phckopper/capivara-hardware/2019-05-20 17.54.45.jpg

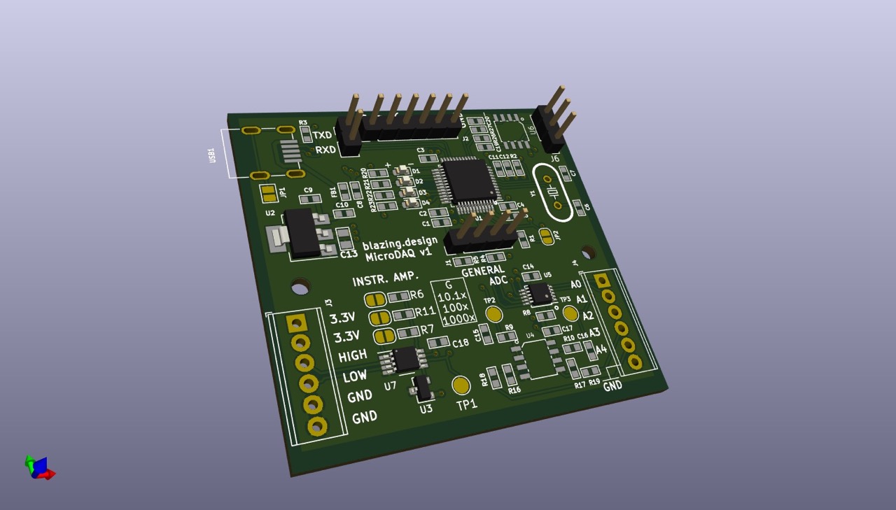
2019-05-20 17.54.45.jpg
