phckopper/capivara-hardware/Schematic.pdf/Capivara.pdf

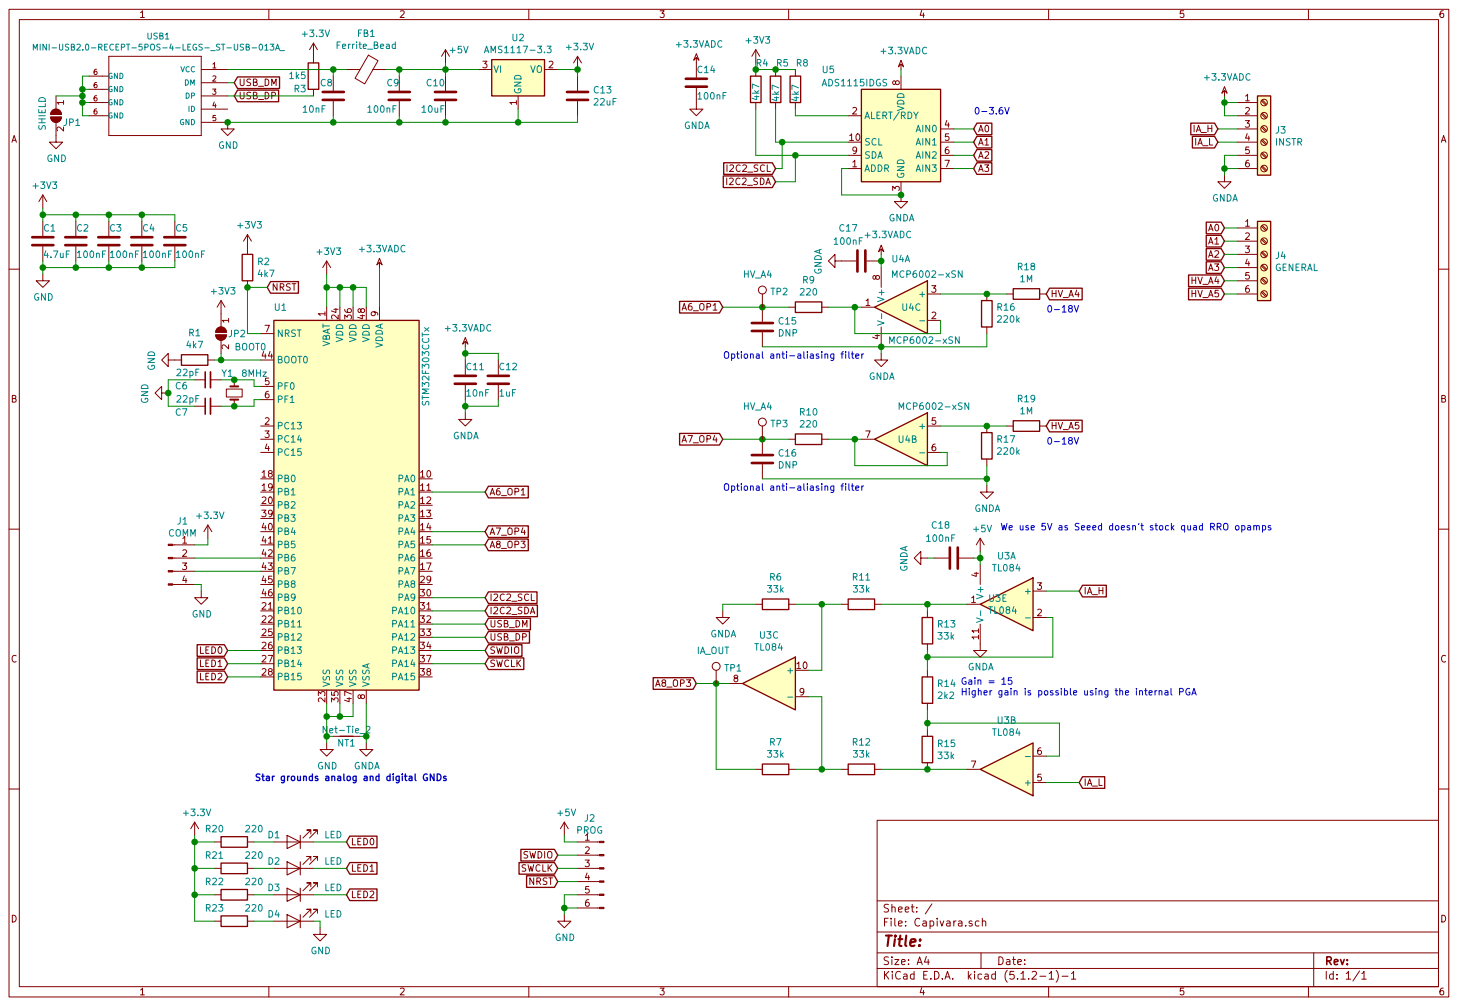
[picture p2: page 1]

1 VDD 24 VDD 36 VDD 48 VDDA

9 VSS 23 VSS 35 VSS 47 VSSA

We use 5V as Seeed doesn't stock quad RRO opamps R11

File: Capivara.sch Sheet: /
Id: 1/1 Title:
