phckopper/capivara-hardware/Assembly/PCB_Assembly.pdf

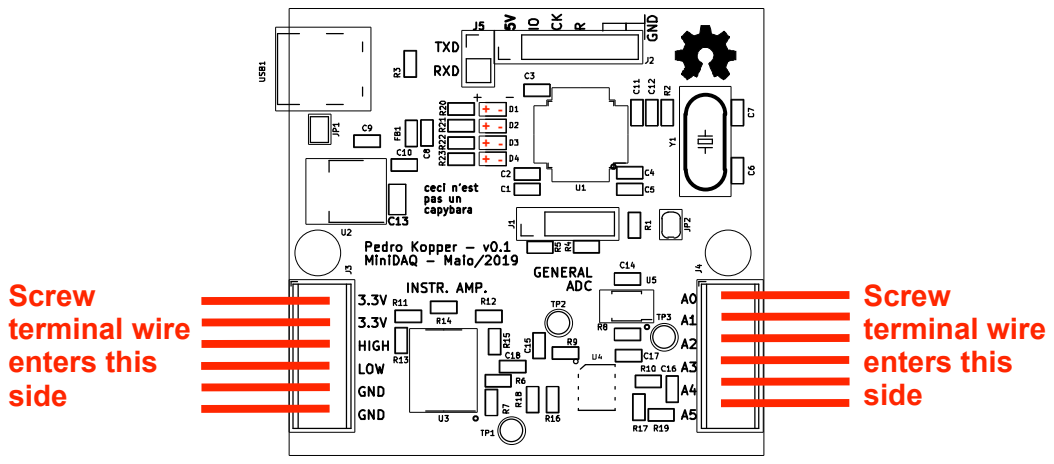
[picture p3: page 1]
