phckopper/capivara-hardware/Fabrication/PCB_Assembly.pdf

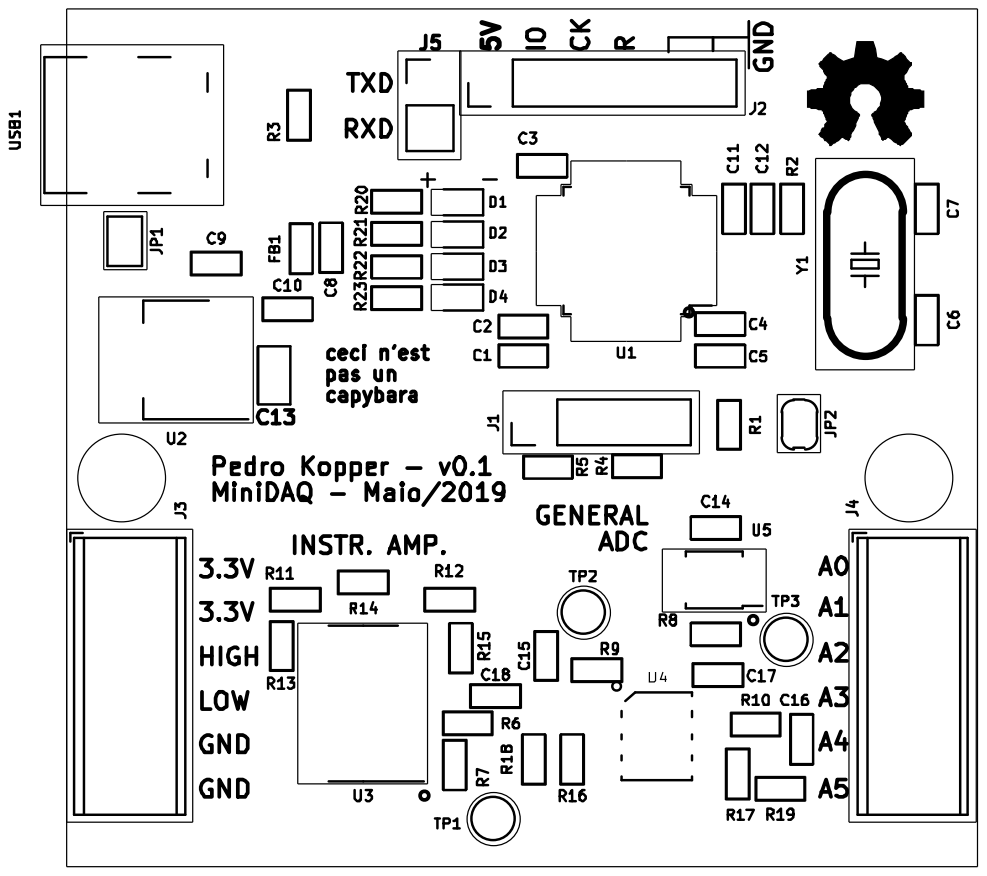
[picture p4: page 1]
