phckopper/capivara-hardware/EsquemaV0.4.pdf

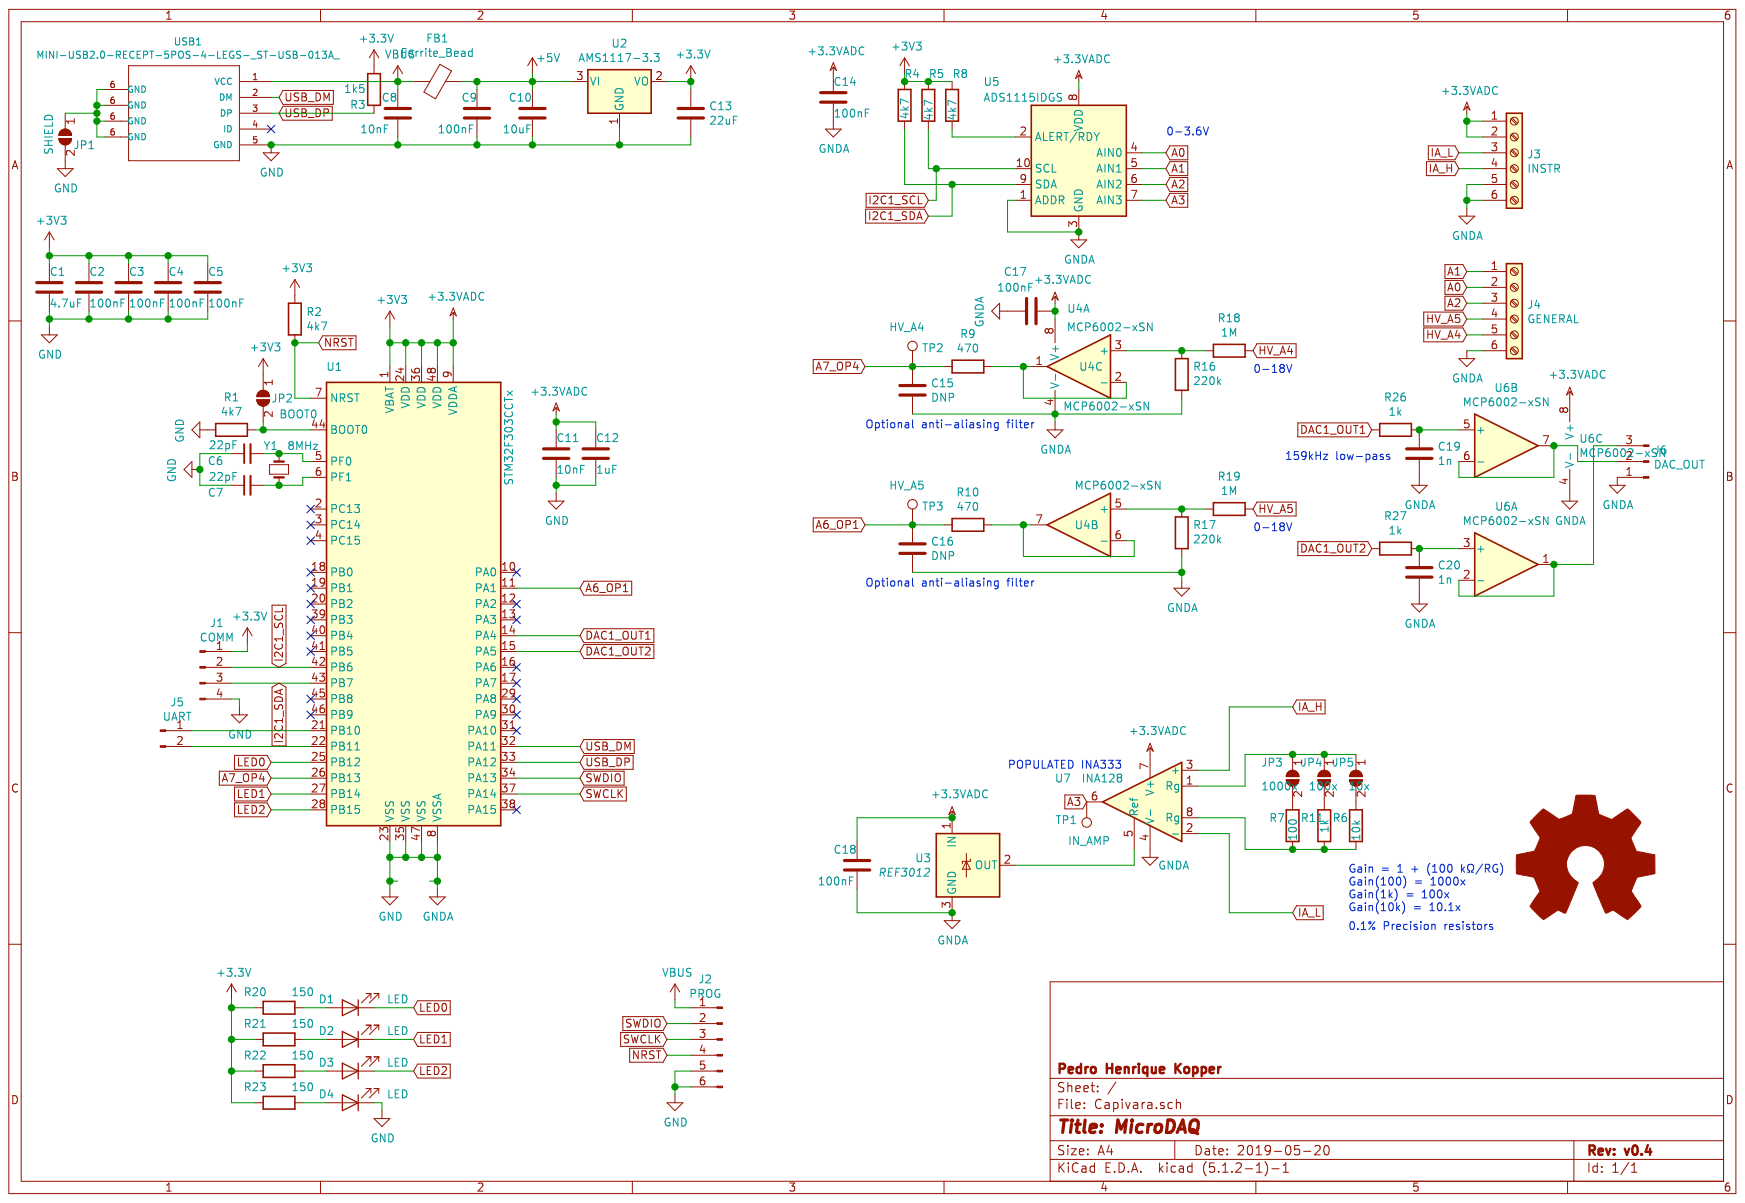
[picture p5: page 1]
