phckopper/capivara-hardware/Esquema_Final2.pdf

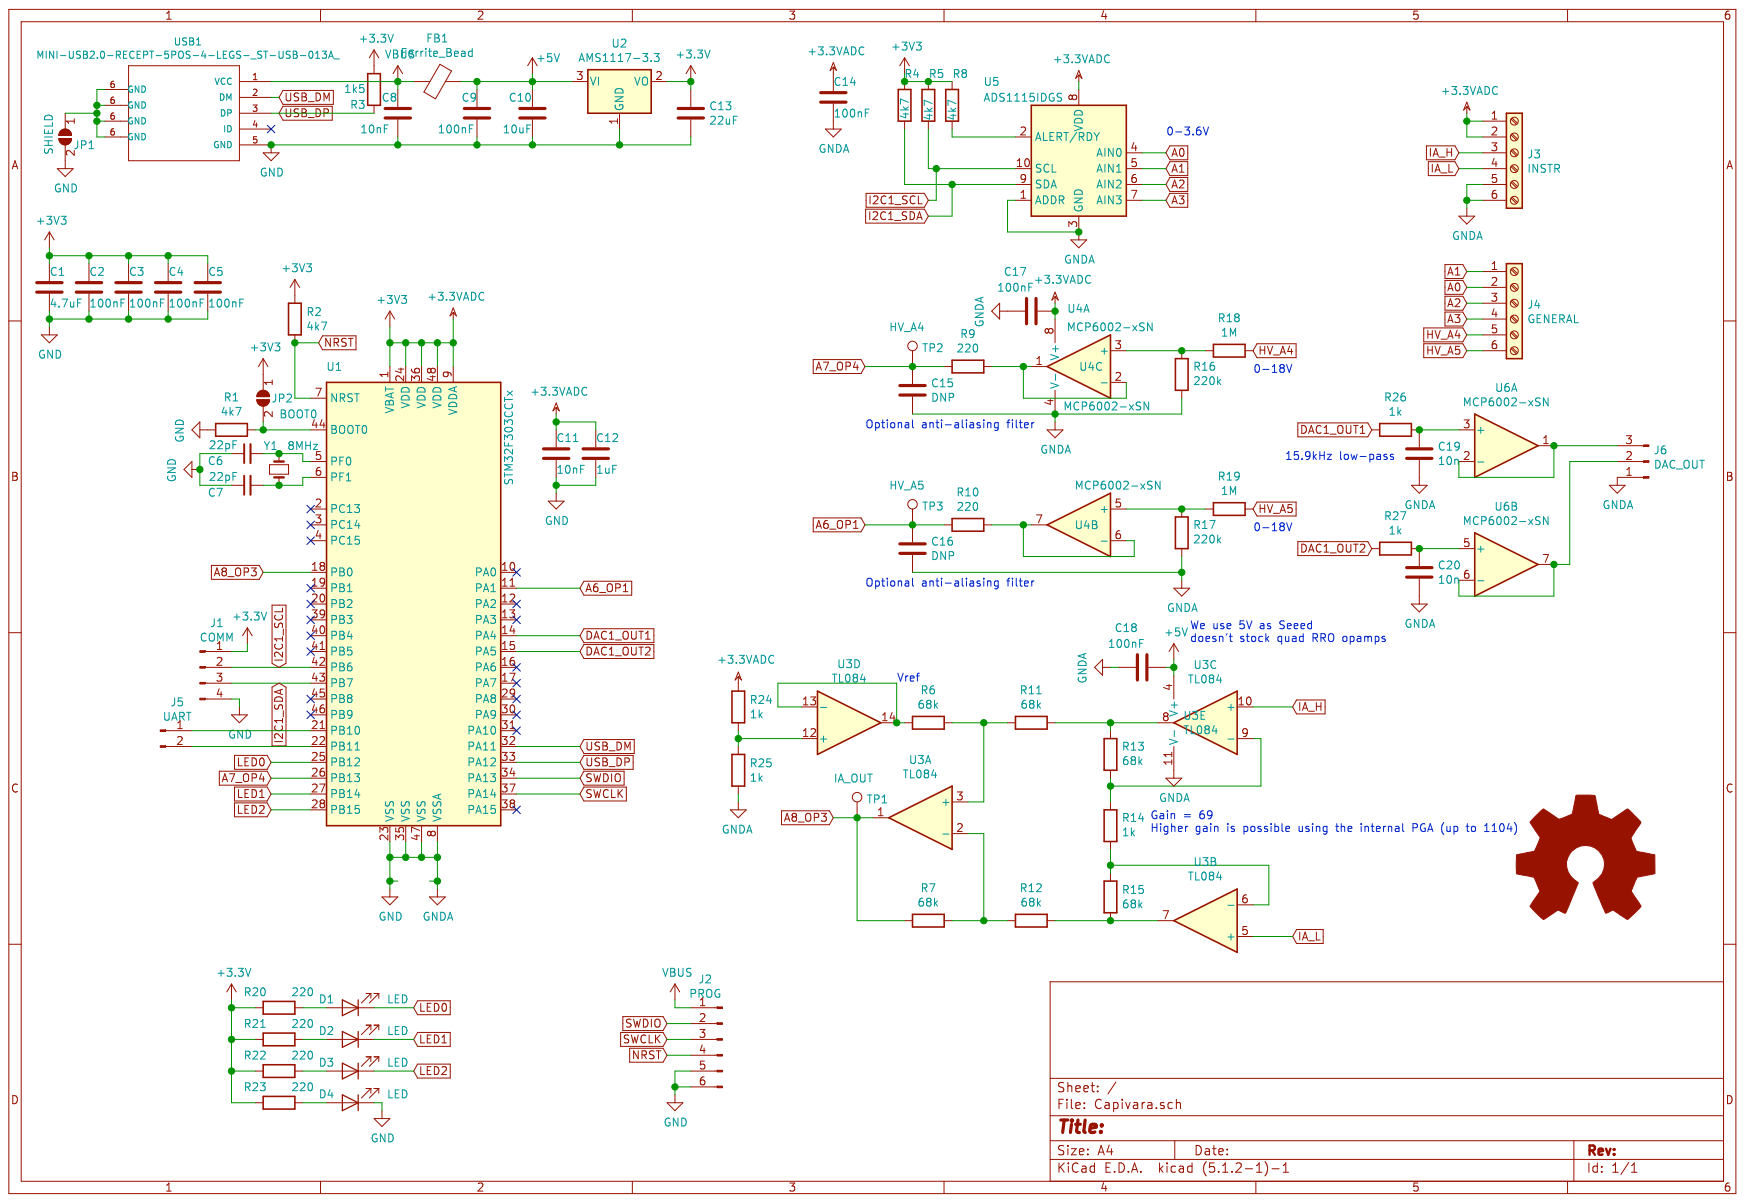
[picture p6: page 1]
