phckopper/capivara-hardware/Esquema_Final3.pdf

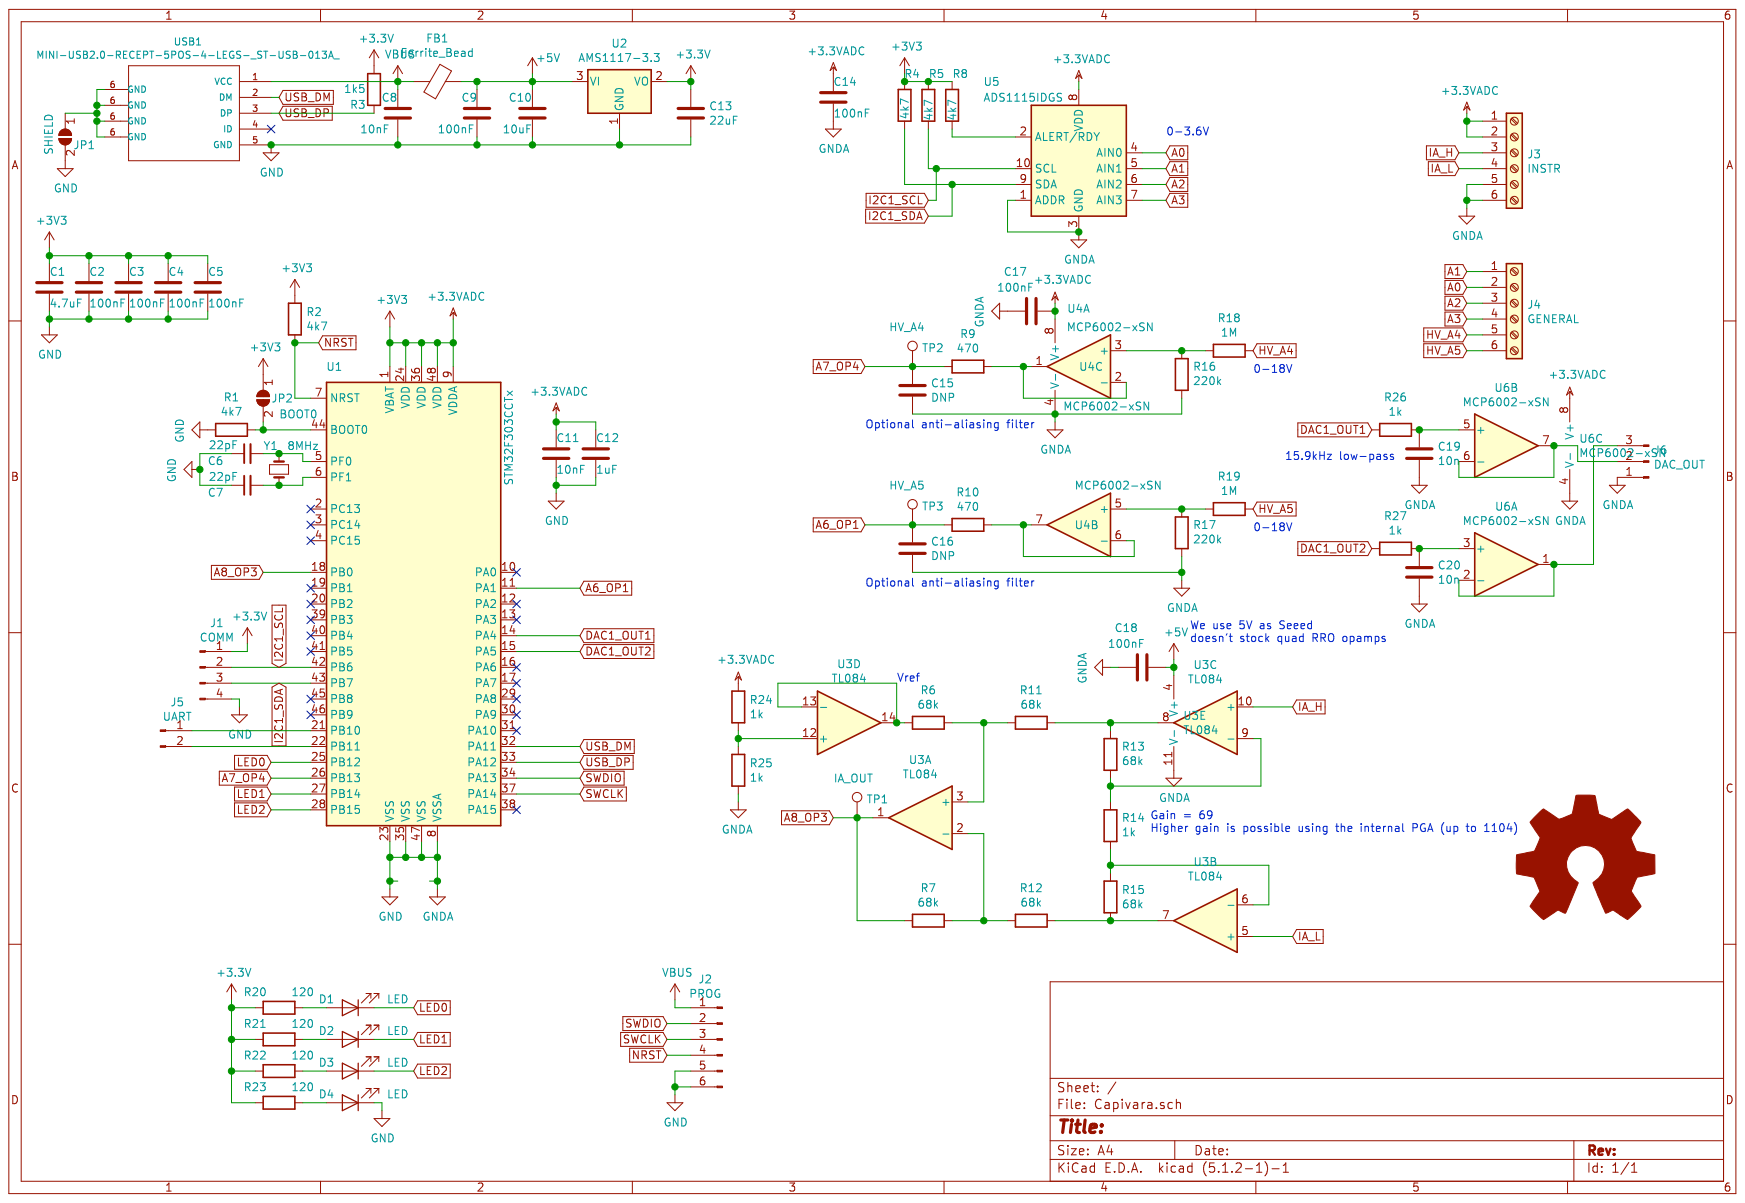
[picture p7: page 1]
