phckopper/capivara-hardware/Esquema_Final.pdf

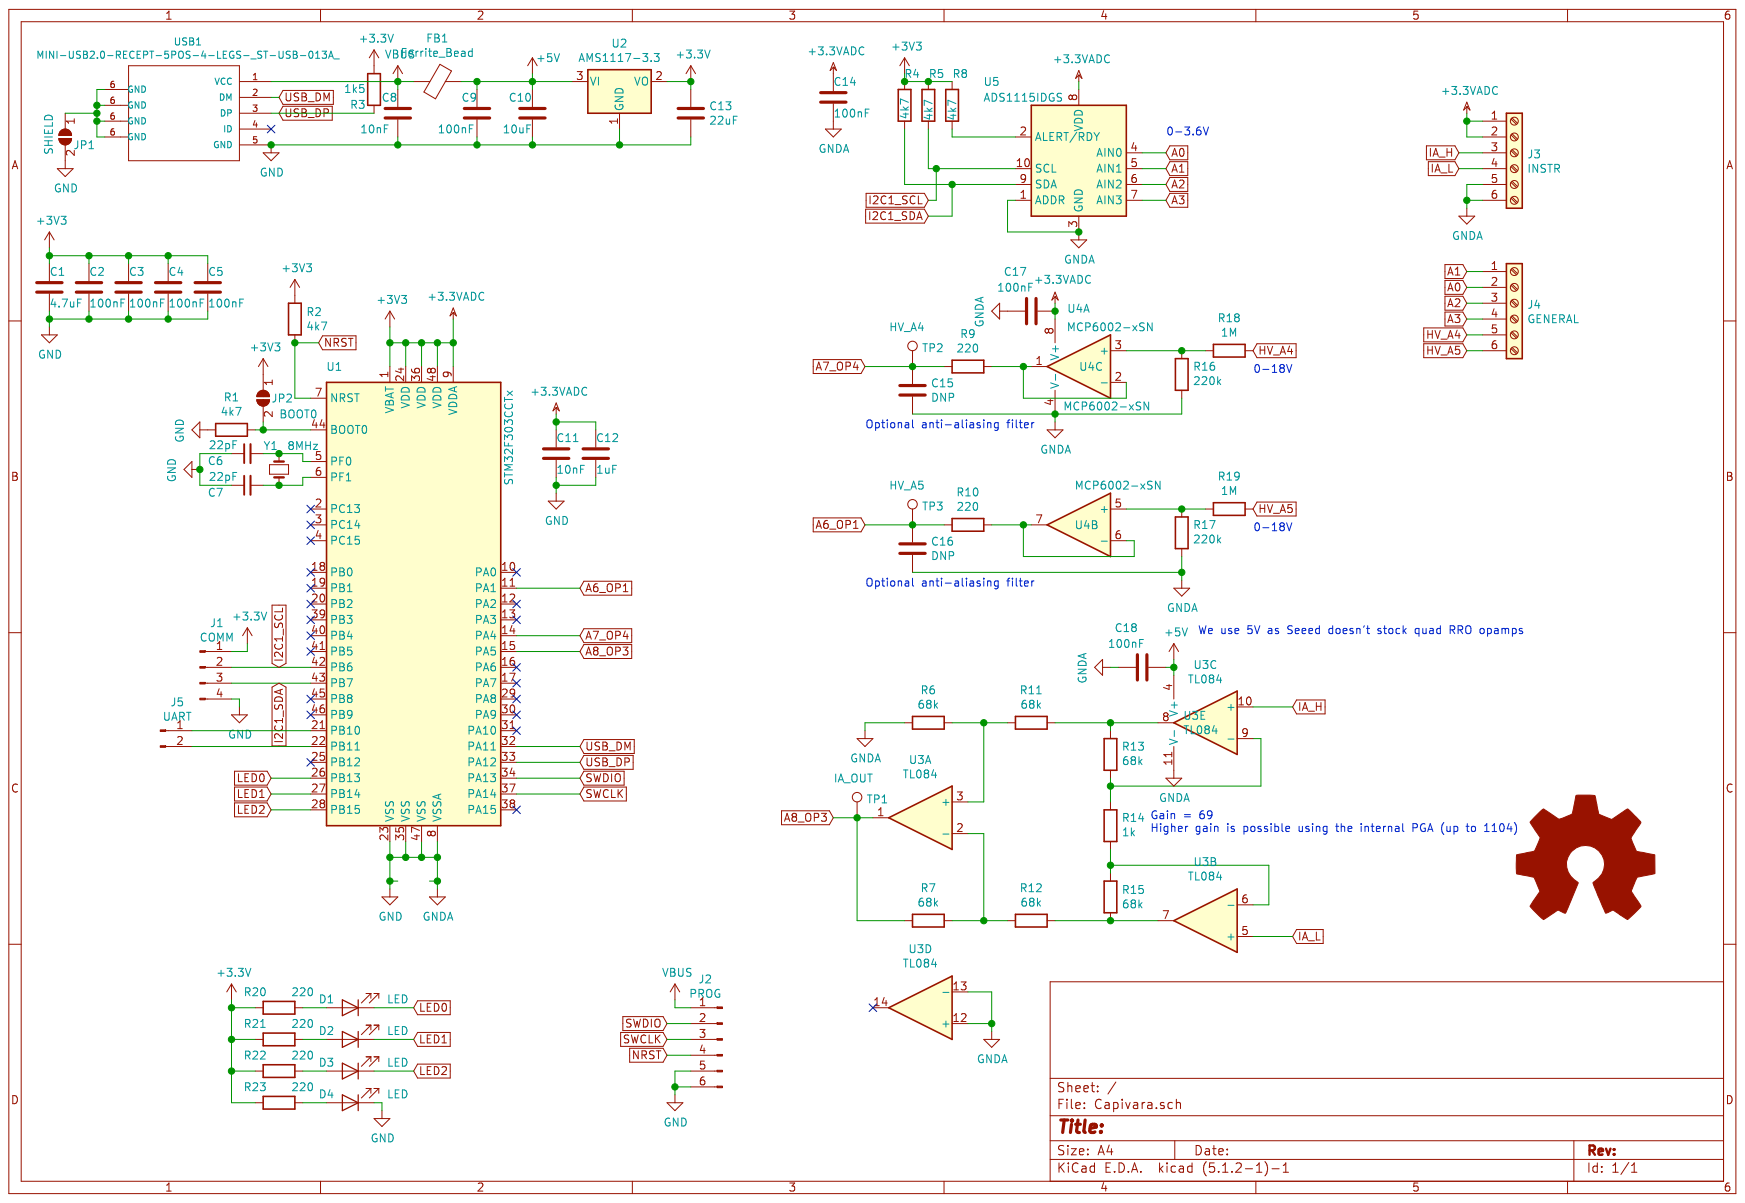
[picture p8: page 1]
