phckopper/capivara-hardware/Esquema.pdf

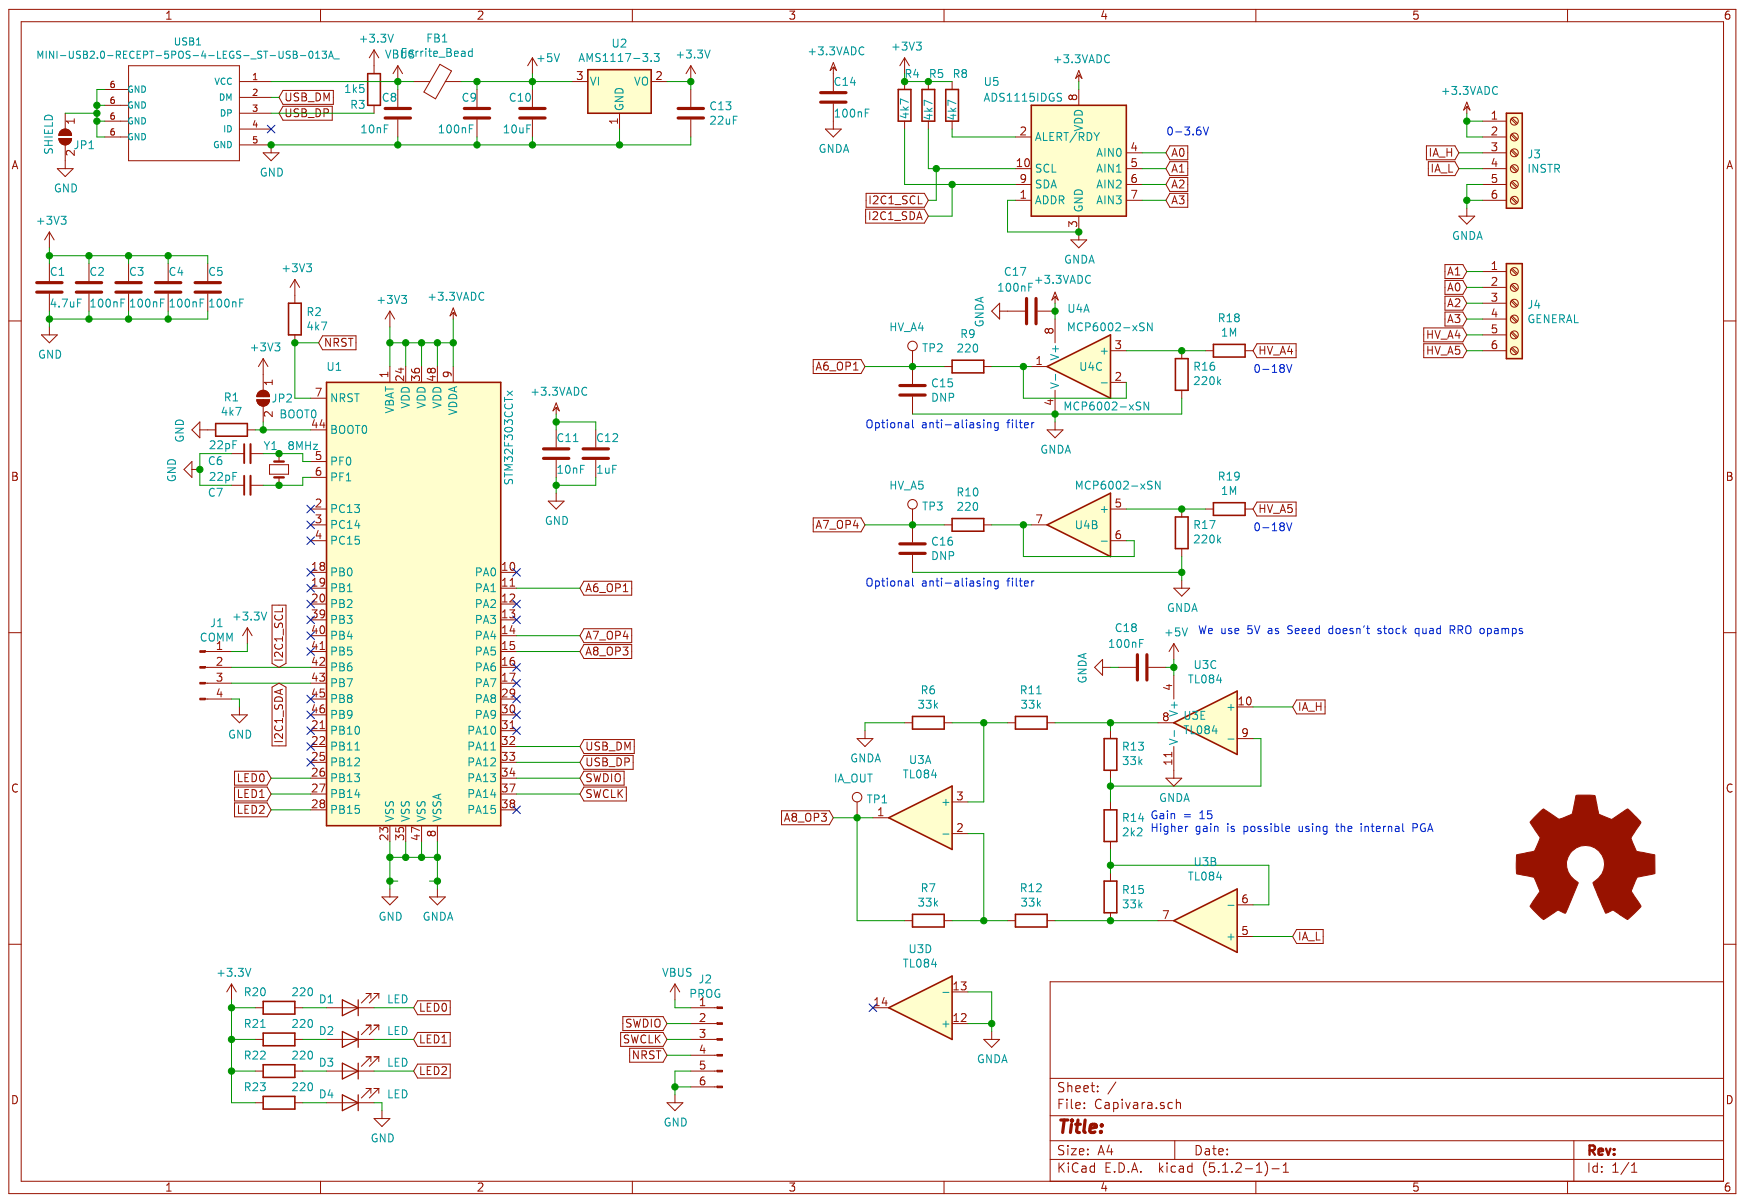
[picture p9: page 1]
