phckopper/capivara-hardware/Capivara.kicad_pcb

## KiCad design Capivara.kicad_pcb (2019-05-20)

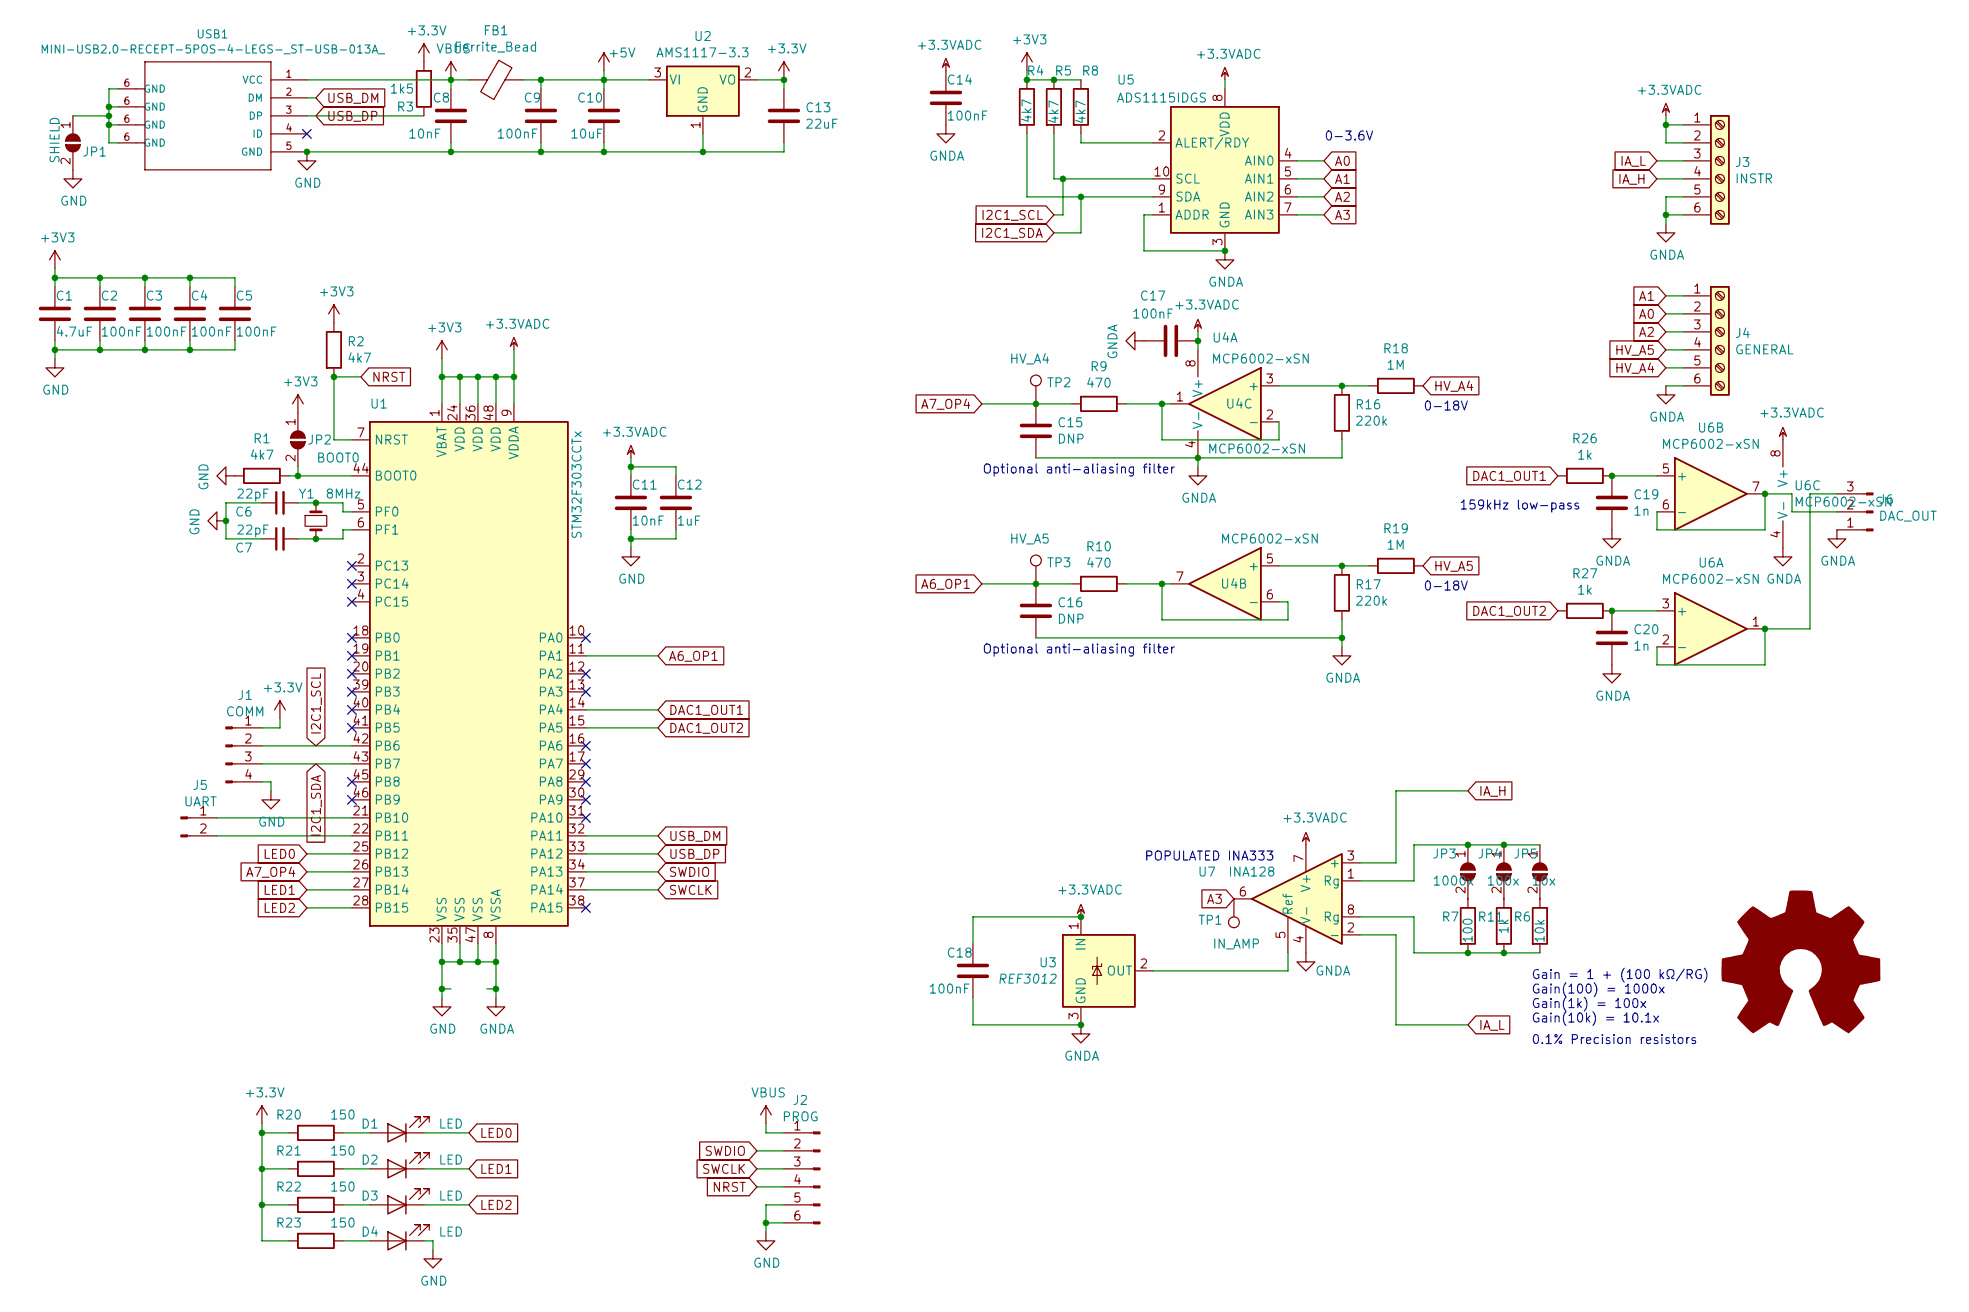
[picture p10: schematic Capivara.sch, MicroDAQ]

Parts:
C1: 4.7uF; R0603
C2, C3, C4, C5, C9, C14, C17, C18: 100nF; R0603
C6, C7: 22pF; R0603
C8, C11: 10nF; R0603
C10: 10uF; R0603
C12: 1uF; R0603
C13: 22uF; R0805
C15, C16: DNP; C0603
C19, C20: 1n; C0603
D1, D2, D3, D4: LED; LED_0603_1608Metric
FB1: Ferrite_Bead; L0603
J1: COMM; PinHeader_1x04_P2.54mm_Vertical
J2: PROG; PinHeader_1x06_P2.54mm_Vertical
J3: INSTR; TerminalBlock_Phoenix_MPT-0,5-6-2.54_1x06_P2.54mm_Horizontal
J4: GENERAL; TerminalBlock_Phoenix_MPT-0,5-6-2.54_1x06_P2.54mm_Horizontal
J5: UART; PinHeader_1x02_P2.54mm_Vertical
J6: DAC_OUT; PinHeader_1x03_P2.54mm_Vertical
JP1: SHIELD; SolderJumper-2_P1.3mm_Open_Pad1.0x1.5mm
JP2: BOOT0; SolderJumper-2_P1.3mm_Open_RoundedPad1.0x1.5mm
JP3: 1000x; SolderJumper-2_P1.3mm_Open_RoundedPad1.0x1.5mm
JP4: 100x; SolderJumper-2_P1.3mm_Open_RoundedPad1.0x1.5mm
JP5: 10x; SolderJumper-2_P1.3mm_Open_RoundedPad1.0x1.5mm
R1, R2, R4, R5, R8: 4k7; R0603
R3: 1k5; R0603
R6: 10k; R0603
R7: 100; R0603
R9, R10: 470; R0603
R11, R26, R27: 1k; R0603
R16, R17: 220k; R0603
R18, R19: 1M; R0603
R20, R21, R22, R23: 150; R0603
TP1: IN_AMP; TestPoint_Pad_D2.0mm
TP2: HV_A4; TestPoint_Pad_D2.0mm
TP3: HV_A5; TestPoint_Pad_D2.0mm
U1: STM32F303CCTx; LQFP-48_7x7mm_P0.5mm
U2: AMS1117-3.3; SOT-223-3_TabPin2
U3: REF3012; SOT-23
U4, U6: MCP6002-xSN; SOIC8-1.27-5X4MM
U5: ADS1115IDGS; TSSOP-10_3x3mm_P0.5mm
U7: INA128; VSSOP-8_3.0x3.0mm_P0.65mm
USB1: MINI-USB2.0-RECEPT-5POS-4-LEGS-_ST-USB-013A_; MINIUSB5+4P-0.8-90D; MPN ST-USB-013A
Y1: 8MHz; HC49US

Connections:
+5V: C9.1, C10.1, FB1.1, U2.3 (VI)
A0: J4.2, U5.4 (AIN0)
A1: J4.1, U5.5 (AIN1)
A2: J4.3, U5.6 (AIN2)
A3: TP1.1, U5.7 (AIN3), U7.6
A6_OP1: C16.1, R10.2, TP3.1, U1.11 (PA1)
A7_OP4: C15.1, R9.2, TP2.1, U1.26 (PB13)
DAC1_OUT1: R26.2, U1.14 (PA4)
DAC1_OUT2: R27.2, U1.15 (PA5)
GND: C1.2, C2.2, C3.2, C4.2, C5.2, C6.1, C7.1, C8.2, C9.2, C10.2, C11.2, C12.2, C13.2, C14.2, C15.2, C16.2, C17.2, C18.2, C19.2, C20.2, D4.1 (K), J1.4, J2.5, J2.6, J3.5, J3.6, J4.6, J6.1, JP1.2 (B), R1.2, R16.1, R17.1, U1.8 (VSSA), U1.23 (VSS), U1.35 (VSS), U1.47 (VSS), U2.1 (GND), U3.3 (GND), U4.4 (V-), U5.1 (ADDR), U5.3 (GND), U6.4 (V-), U7.4 (V-), USB1.5 (GND)
HV_A4: J4.5, R18.1
HV_A5: J4.4, R19.1
I2C1_SCL: J1.2, R5.2, U1.42 (PB6), U5.10 (SCL)
I2C1_SDA: J1.3, R4.2, U1.43 (PB7), U5.9 (SDA)
IA_H: J3.4, U7.3 (+)
IA_L: J3.3, U7.2 (-)
LED0: D1.1 (K), U1.25 (PB12)
LED1: D2.1 (K), U1.27 (PB14)
LED2: D3.1 (K), U1.28 (PB15)
NRST: J2.4, R2.2, U1.7 (NRST)
unnamed: C6.2, U1.5 (PF0), Y1.1
unnamed: C7.2, U1.6 (PF1), Y1.2
unnamed: C19.1, R26.1, U6.5 (+)
unnamed: C20.1, R27.1, U6.3 (+)
unnamed: D1.2 (A), R20.1
unnamed: D2.2 (A), R21.1
unnamed: D3.2 (A), R22.1
unnamed: D4.2 (A), R23.1
unnamed: J5.1, U1.21 (PB10)
unnamed: J5.2, U1.22 (PB11)
unnamed: J6.2, U6.6 (-), U6.7
unnamed: J6.3, U6.1, U6.2 (-)
unnamed: JP1.1 (A), USB1.6 (GND)
unnamed: JP2.2 (B), R1.1, U1.44 (BOOT0)
unnamed: JP3.1 (A), JP4.1 (A), JP5.1 (A), U7.1 (Rg)
unnamed: JP3.2 (B), R7.1
unnamed: JP4.2 (B), R11.1
unnamed: JP5.2 (B), R6.1
unnamed: R8.2, U5.2 (ALERT/RDY)
unnamed: R9.1, U4.1, U4.2 (-)
unnamed: R10.1, U4.6 (-), U4.7
unnamed: R6.2, R7.2, R11.2, U7.8 (Rg)
unnamed: R16.2, R18.2, U4.3 (+)
unnamed: R17.2, R19.2, U4.5 (+)
unnamed: U3.2 (OUT), U7.5 (Ref)
SWCLK: J2.3, U1.37 (PA14)
SWDIO: J2.2, U1.34 (PA13)
USB_DM: U1.32 (PA11), USB1.2 (DM)
USB_DP: R3.1, U1.33 (PA12), USB1.3 (DP)
VBUS: C8.1, FB1.2, J2.1, USB1.1 (VCC)

Notes on the sheet:
0-18V
0-3.6V
Optional anti-aliasing filter
159kHz low-pass
Gain = 1 + (100 kΩ/RG) Gain(100) = 1000x Gain(1k) = 100x Gain(10k) = 10.1x
POPULATED INA333
0.1% Precision resistors

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
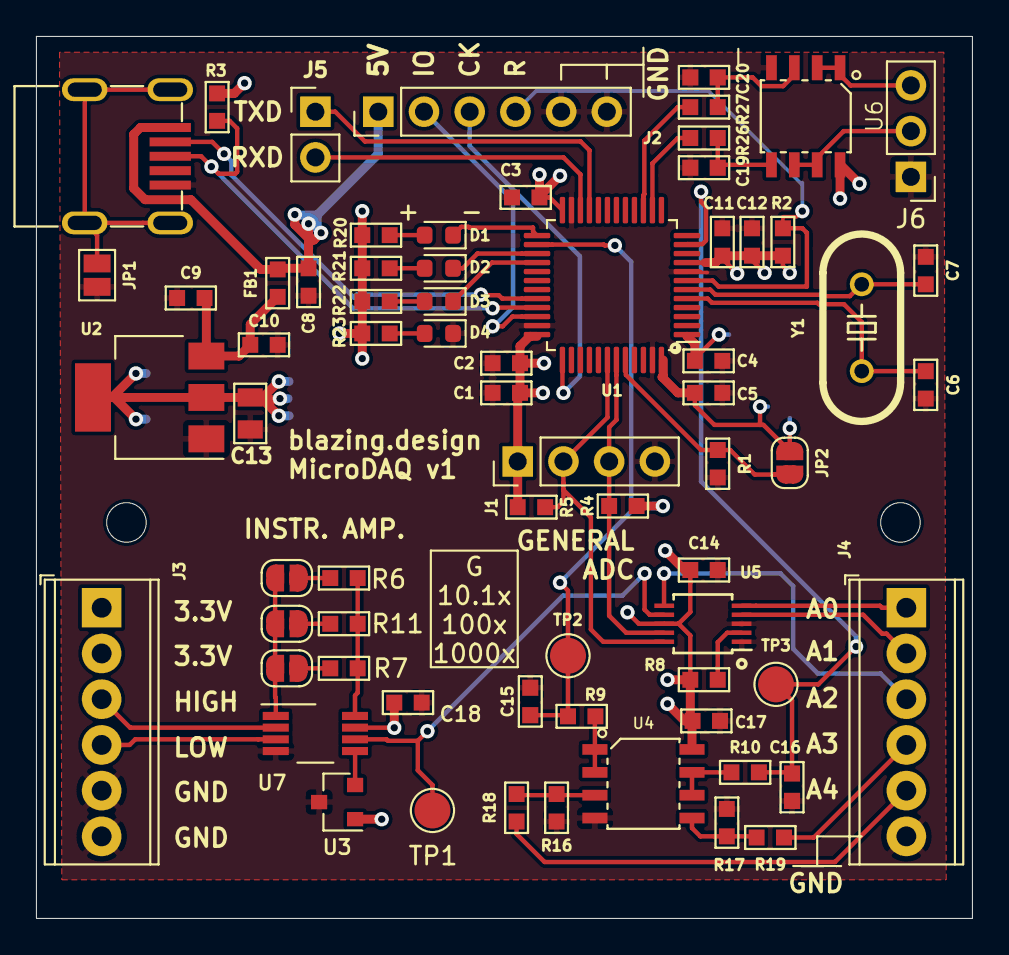
[picture p11: board Capivara.kicad_pcb from above]

Board: 2 copper layers, 52.0 x 49.0 mm, 69 parts (0 on the bottom side), 51 nets.
