phckopper/capivara-hardware/(commit log)

2019-05-14 Add fab files
    [Capivara-B_Cu.gbl, Capivara-B_Mask.gbs, Capivara-B_Paste.gbp, Capivara-B_SilkS.gbo, Capivara-Edge_Cuts.gm1, Capivara-F_Cu.gtl, Capivara-F_Mask.gts, Capivara-F_Paste.gtp]
2019-05-15 Mudanças Pezzi
    [Capivara.kicad_pcb, Capivara.sch]
2019-05-20 Usar INA ao invés de InsOp discreto
    [Capivara.kicad_pcb, Capivara.sch]
